teutronic-gmbh/corona-killer/Hardware/Zusatzplatine/ZusatzPlatine_Lochrasteraufbau.jpg

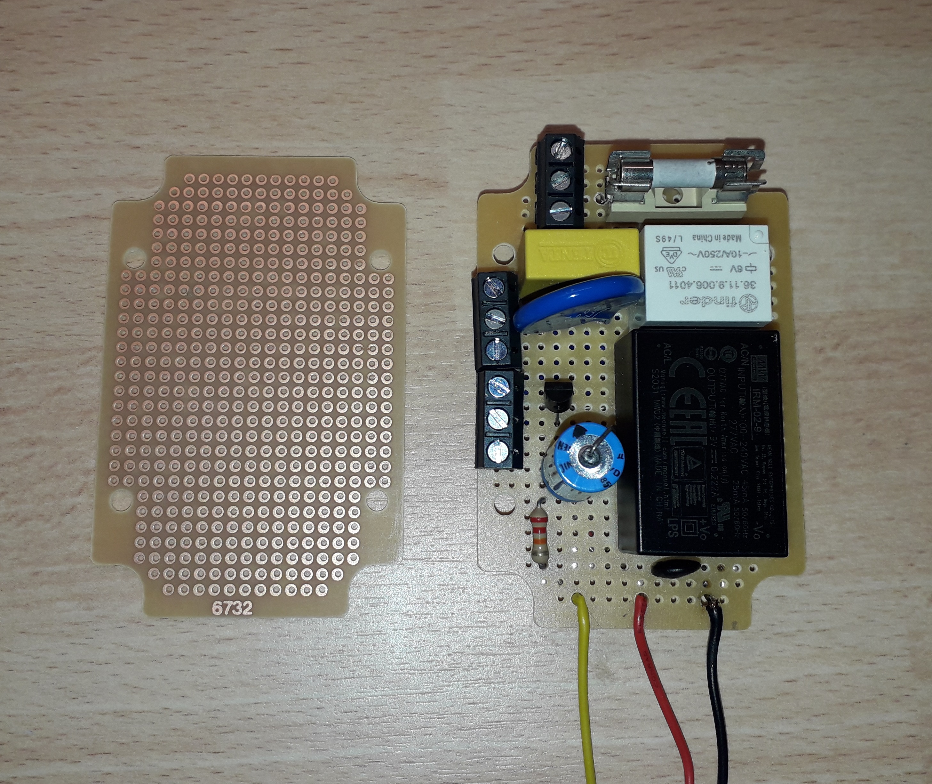
Hardware/Zusatzplatine/ZusatzPlatine_Lochrasteraufbau.jpg
