teutronic-gmbh/corona-killer/Hardware/Verdrahtung2.jpg

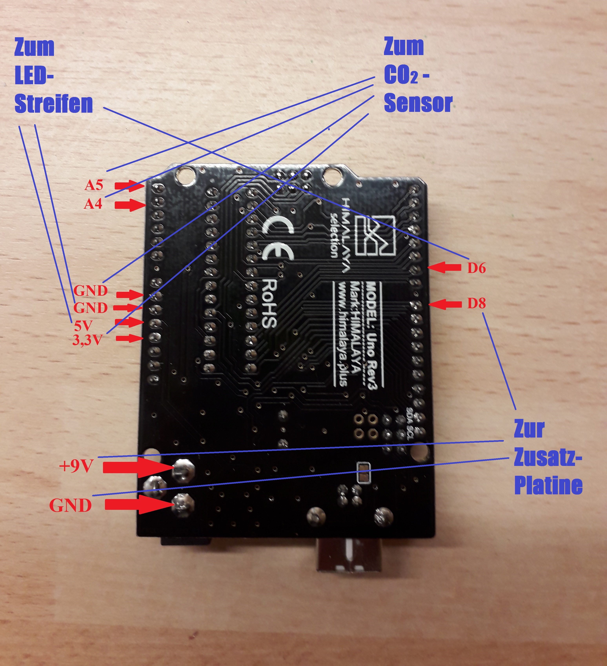
Hardware/Verdrahtung2.jpg
