teutronic-gmbh/corona-killer/README.md

# Corona-Killer

Luftsterilisation mittels UV-Licht

entworfen für den Einsatz in Klassenräumen im Winterhalbjahr 2020/2021

die eingebaute CO2-Messung erkennt die Anwesenheit von Schülern und schaltet die Luftsterilisation ein
