teutronic-gmbh/corona-killer/Hardware/Zusatzplatine/EAGLE/Luftsterilisator_1.3/Gerber/info.txt

Gerberfiles für Projekt "Coronakiller Zusatzplatine" Version 1.3 vom 26.11.2020

bei Problemen bitte hier nachfragen:

andreas.hertel@teutronic.de
Tel: 04137 810197
Mobil: 0170 3464377
