teutronic-gmbh/corona-killer/Hardware/Verdrahtung.png

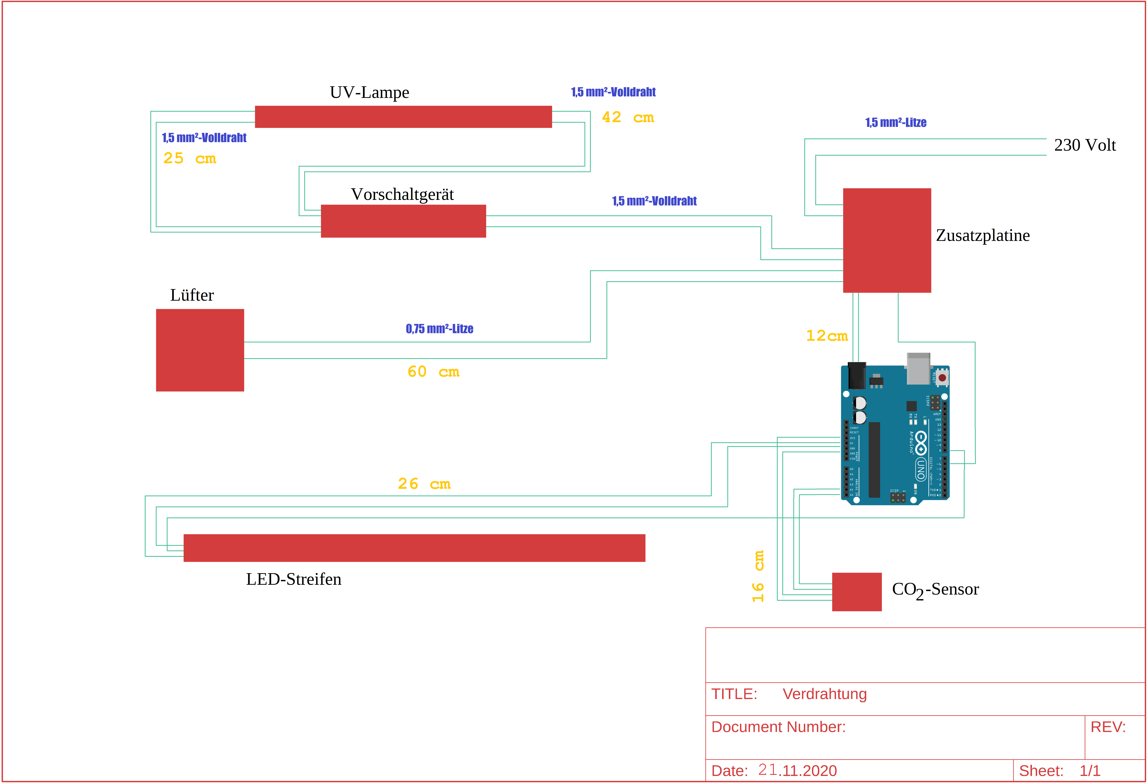
Hardware/Verdrahtung.png
