teutronic-gmbh/corona-killer/Materialliste.ods

Materialliste Coronakiller
Summe der Einzelpreise (inkl.MWSt): | 119,44 € | Anmerkung: hier nach dem 1.1.21 den Faktor 1,19 eintragen
 | Einzelpreis (netto) | Gebindepreis | Anzahl | Quelle | Bestellnummer | EAN
Osram Entkeimungslampe HNS 16W G5 25X1 | 5,18 € | 51,80 € | 10 | conrad.de | 756912 - 62 | 4008321620774
Lampenfassung G5 2er Set | 3,35 € | 33,50 € | 10 | conrad.de | 574874 – 62 | 4040267029334
LED Streifen 10er | 1,96 € | 5,87 € | 3 | conrad.de | 2161033 – 62 | 8717371232894
UNO R3 ATmega328P Board | 6,75 € |  |  | conrad.de | 802287391 – 62 | 4060137001697
SGP30 CO2 Sensor | 16,72 € |  |  | digikey.de | 1528-2531-ND
Vorschaltgerät 18W | 5,79 € |  |  | amazon.de | B00AGHVMQI
230V-Anschlußschnur | 1,74 € |  |  | voelkner.de | S382581 | 4016032311829
Rohreinschublüfter 180m³/h 125 | 27,88 € |  |  | abluft24.de | K011004s | 4251724209552
Gitter 125 2x | 5,07 € |  |  | abluft24.de | K111004 | 4251724204908 | (preiswerter Ersatz für AirCircleN33225)
Gitter 100 AirCircleN33212 2x | 6,47 € |  |  | Bauhaus.info | 13506934
PVC Rohr 125; 50 cm AirCircleN26202 | 6,68 € |  |  | Bauhaus.info | 13507452
Lüftungsschellen m.Einlage 2x | 4,36 € |  |  | abluft24.de | K101404 | 4251724204045
 |  |  |  |  |  |  | Nur für gedruckte Schaltung
Lochraster-Platine | 0,73 € |  |  | voelkner.de | S490641 | 2050004889628 | voelkner.de | S490641
3er Block Schraubklemme 3x | 0,45 € | 3,75 € | 25 | voelkner.de | D29609 | 2050000682551 | voelkner.de | D29609
Sicherung 1,6A träge | 0,17 € | 4,25 € | 25 | voelkner.de | S483451 | 2050004896558 | voelkner.de | S483451
Sicherungshalter | 0,13 € | 1,30 € | 10 | voelkner.de | S22688 | 2050000172588 | voelkner.de | S22688
MW IRM 02-9 | 4,61 € |  |  | voelkner.de | D920041 | 4021087034647 | voelkner.de | D920041
Relais | 1,16 € | 5,80 € | 5 | voelkner.de | S72788 | 2050000149450 | voelkner.de | S72788
NPN-Transistor | 0,16 € |  |  | conrad.de | 155012 – 62 | 2050000029431 | voelkner.de | Q35055
10kOhm-Widerstand | 0,06 € |  |  | conrad.de | 1417697 – 62 | 2050003798495 | voelkner.de | W78205
Kondensator 330nF / 400 Volt | 0,58 € |  |  | conrad.de | 808761445 – 62 |  | voelkner.de | W30668
Varistor S14K275 | 0,47 € |  |  | conrad.de | 500675 - 62 | 2050000141591 | voelkner.de | S29134
Kondensator 10µF | 0,42 € |  |  | conrad.de | 445591 – 62 | 2050000119705 | voelkner.de | W426471
Kondensator 100nF | 0,08 € |  |  | conrad.de | 1589524 – 6 | 2050004969900 | voelkner.de | W572401
Drähte (geschätzt) | 1,00 €
Schrauben/Muttern (geschätzt) | 1,00 €
UV-C Schutzbrille |  |  |  | conrad.de | 836647 – 62 | 4046719298037
