teutronic-gmbh/corona-killer/(threads)

Thread 2 (2020-11-06):

Refelktion der UV-Strahlung im Rohr

stockh0lm, 2020-11-06:
Wenn ich den Aufbau richtig verstehe ist das Rohr ein normales KG-Rohr, gell? In der Rechnung wird davon ausgegangen, dass das UV-Licht an der Oberfläche des Rohres (verlustfrei) gespiegelt wird.

- ist das KG-Rohr UV-stabil? KG-Rohre die ich an der Sonne sehe verfärben sich.
- für die Luftsterilisation ist es wichtig, dass möglichst viel der UV-Strahlung von der Wand zurückreflektiert wird. Ist das der Fall? kann man das Innere der Röhre sonst vielleicht mit Alufolie auskleiden oder ein Metallrohr nehmen?

teutronic-gmbh, 2020-11-06:
Ich hab da tatsächlich Alufolie verklebt wie sie zum Tapezieren verwendet wird. Die hat eine Rückseite mit Papier. Beim ersten Mal habe ich das ganz zum Schluss gemacht und überall mit dem Kleber rumgesaut. Das muss zu einem früheren Zeitpunkt des Zusammenbaus passieren. Daran feile ich noch  :-)

stockh0lm, 2020-11-14:
I read the mirror sheeting i am going to put in (or even the aluminium of a pipe reflects around 90% of the UV radiation back. That value is important to know for further simulation or calculation of the effective radiation intensity in the pipe.

Closed 2020-11-14.

Thread 3 (2020-11-06):

Fertigplatinen statt Lochrasterplatinen?

stockh0lm, 2020-11-06:
Es wäre möglich, Fehler bei der Verdrahtung zu vermeiden, indem man die Lochrasterplatine durch eine geätzte Platine ersetzt. Jemand (nicht notwendigerweise @teutronic-gmbh ) könnte ein solches Layout erstellen und beitragen, und Interessierte Schulen könnten die Platine in Kleinserie herstellen.

teutronic-gmbh, 2020-11-06:
Unter https://github.com/teutronic-gmbh/corona-killer/tree/main/Hardware/Zusatzplatine/EAGLE/Luftsterilisator
hab ich bereits eine solche Platine abgelegt, das mit dem Tool Eagle erstellt wurde.
Bisher wurde das aber noch nicht geätzt, ist also noch mit Vorsicht zu genießen. Ich will aber davon Platinen anfertigen lassen

Thread 4 (2020-11-06):

Sprache des Projekts

stockh0lm, 2020-11-06:
Es wäre möglich, das Projekt mehrsprachig aufzuziehen und Interessierten Übersetzern die Möglichkeit zu bieten, Landesspezifische Schoppinglisten und Anleitungen beizutragen. Wenn die englische Sprache als Standard hier auf Github keine Hürde für @teutronic-gmbh darstellt, würde das die Reichweite des Projekts vergrößern.

stockh0lm, 2020-11-14:
So i spoke with Andreas on the phone and she said that English would be fine for the primary language of this project. That means I will continue in english.

Closed 2020-11-14.

Thread 5 (2020-11-14):

perhaps one should add "sunglasses" to the shopping list?

stockh0lm, 2020-11-14:
After reading the product data sheet
https://dammedia.osram.info/media/resource/hires/osram-dam-4121389/PURITEC%20HNS%20Brochure%20(EN).pdf
I realize that protectie clothing might be advisable for construction and testing, as long as the caps are not installed on the tube.

The UV light can swiftly lead to sunburn and cause strong irritation to the eyes. sunglasses would prevent that.

Thread 6 (2020-11-14):

the UV light (the 185nm spectral line) of the lamp will generate ozon

stockh0lm, 2020-11-14:
While the product data sheet of the lamp says the lamp is ozon free, it also states that the wavelengths below 250nm will generate ozon, and the 185nm spectral line will likely do so.

Can we find out how much ozon is generated (gram/hour), and what results that has for humans in school classes? what are the permissive limits?

stockh0lm, 2020-11-14:
ok, this was not entirely correct. The specs say that the second spectral line at 185nm is filtered out by the special glass of the lamps, and the only UVC light coming out has 254nm - so no ozon after all.

Closed 2020-11-14.

Thread 7 (2020-11-14):

Noise level of the fan

stockh0lm, 2020-11-14:
I bought a medium range fan for 35€ which was marketed to be rather silent. Now that I hooked it up I dont find it so silent. It says 38dBA on the label. So in the future I would go for more expensive, more silent versions.

Thread 9 (2020-11-14):

Tool "ray optic simulation" to model the radiation density with different placements of the source

stockh0lm, 2020-11-14:
https://chrome.google.com/webstore/detail/ray-optics-simulation/egamlemiidmmmcccadndbjjihkcfiobh

this is a chrome extension that allows to model our setup and lets you play around with the source placement in the pipe.

stockh0lm, 2020-11-15:
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

this is the configuration as suggested in the schematics, modeled with this json file:

{"version":2,"objs":
[
  {"type":"arcmirror",
  "p1":{"type":1,"x":0,"y":725,"exist":true},
  "p2":{"type":1,"x":0,"y":726,"exist":true},
  "p3":{"type":1,"x":1250,"y":725,"exist":true}
},
  {"type":"radiant","x":150,"y":725,"p":0.001}],"mode":"light","rayDensity_light":0.05,"rayDensity_images":1,"observer":null,"origin":{"x":0,"y":0}
}

stockh0lm, 2020-11-15:
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

This is the configuration with the light source in the middle:

{"version":2,"objs":
[
  {"type":"arcmirror",
  "p1":{"type":1,"x":0,"y":725,"exist":true},
  "p2":{"type":1,"x":0,"y":726,"exist":true},
  "p3":{"type":1,"x":1250,"y":725,"exist":true}
},
  {"type":"radiant","x":625,"y":725,"p":0.001}],"mode":"light","rayDensity_light":0.05,"rayDensity_images":1,"observer":null,"origin":{"x":0,"y":0}
}

stockh0lm, 2020-11-15:
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

This is the configuration with the light source at half the pipe-radius (31.7mm), with this json file:

{"version":2,"objs":
[
  {"type":"arcmirror",
  "p1":{"type":1,"x":0,"y":725,"exist":true},
  "p2":{"type":1,"x":0,"y":726,"exist":true},
  "p3":{"type":1,"x":1250,"y":725,"exist":true}
},
  {"type":"radiant","x":317,"y":725,"p":0.001}],"mode":"light","rayDensity_light":0.05,"rayDensity_images":1,"observer":null,"origin":{"x":0,"y":0}
}

stockh0lm, 2020-11-15:
This shows that the placement of the light source would be best in the middle of the pipe. The rule of thumb would be: the more in the middle the better.

stockh0lm, 2020-11-15:
with raytracing software like Blender this can be modeled better.

Thread 11 (2020-11-25):

insufficient irradiation intensity?

stockh0lm, 2020-11-25:
Depending on the source of the irradiation dose for sars-cov-19, it is either 611uJ/cm^2 or 10,3mJ/cm^2. (The first one is from a marketing paper, so i would rather rely on the second, which is from a scientific paper.

In my current configuration (where i measured the air speed in the tube) and according to my calculation, we do not reach that dose reliably.

Here is my calculation:

measured air speed in the tube with vane annemometer: 3m/s
UVC irradiation power from lamp: 4W
(from https://www.osram.de/ecat/PURITEC%20HNS%20UV-C-UV-C%20lamps%20for%20purification-Ultraviolettstrahler-Industrie-Spezialbeleuchtung/de/de/GPS01_1028570/ZMP_1022255/ )
With the lamp in the center of the tube we have a radialsymmetrical irradiation distribution, weakest at the inner tube surface. This surface A is 12.5cm * 22.8cm * pi = 895cm^2
irradiation power / surface: 4W/895cm^2 = 0.004467W/cm^2
mean residence time of air/germ in irradiation: 0.228m / 3m/s = 0.076s

irradiation dose at inner tube surface: 0.076s* 0.004467W/cm^2 = 339uJ/cm^2

You could argue that due to the reflection on the inner mirror surface of the tube the irradiation is twice that value. I would not like to argue that way, because the 4W are not actually focused in the volume but spread out further. That increases the mean residence time, but decreases the irradiation power.  Even then we would just reach the lower, first marketing paper numer for the irradiation dose, but fall short of the second by a factor of 30.

Only the inner fifth of the tube would reach the precribed irradiation dose of 10.3mJ/cm^2. While the germicidal effect outside that volume is still there, it might not reach the desired 90%.

stockh0lm, 2020-11-25:
According to https://www.osram.de/appsj/pdc/pdf.do?cid=GPS01_1028570&vid=PP_EUROPE_DE_eCat&lid=DE&mpid=
which lists the other germicidal lamps by osram, even the high end bulb HNS L 95 W 2G11 with 27 W UVC output and a length of 533,0 mm would not reach the required radiation intensity. I do hope that I screwed up this calculation. Please check, someone.

stockh0lm, 2020-11-26:
it appears that the 10.3mJ/cm^2 is for 99% inactivation dose, not 90%. see other issue.

stockh0lm, 2020-12-01:
import numpy as np

step_num = 1e4

r_l = .016 / 2
r_c = .125 / 2
stepsize = (r_c - r_l) / step_num

l = .205
k = .41
v = 3.0
e = 4.0

t = l / v

volume_total = 2 * np.pi * l * (r_c ** 2 - r_l ** 2)

killrate = 0.0
for r_diff in np.arange(r_l, r_c, stepsize):
    i = e / (2 * np.pi * l * r_diff)
    d = i * t
    p = 1 - np.exp(-k * d)
    v_diff = np.pi * l * (r_diff * stepsize + stepsize ** 2)
    volume_partial = v_diff / volume_total
    killrate += p * volume_partial

print("killrate_total: ", killrate)

This will calculate the overall killrate of our device with the current configuration and the parameters i was able to collect and measure.

it calculates a overall killrate of 0.21685570284082964.
21% of covid-19 viruses that pass through the device are killed. That is not as impressive as i had hoped.

What can we do to make the device more potent?

stockh0lm, 2020-12-01:
Since the intensity and dose decrease quadratically with distance, it could help (a lot) to install several equidistant lamps into one pipe. I will try to compute what killrate is attainable that way.

stockh0lm, 2020-12-01:
after finding two bugs in my calculation and arriving at a killrate of 0.86, i am happy and close this issue

Closed 2020-12-01.
