teutronic-gmbh/corona-killer/Hardware/Zusatzplatine/coronakiller_Zusatzplatine.pdf

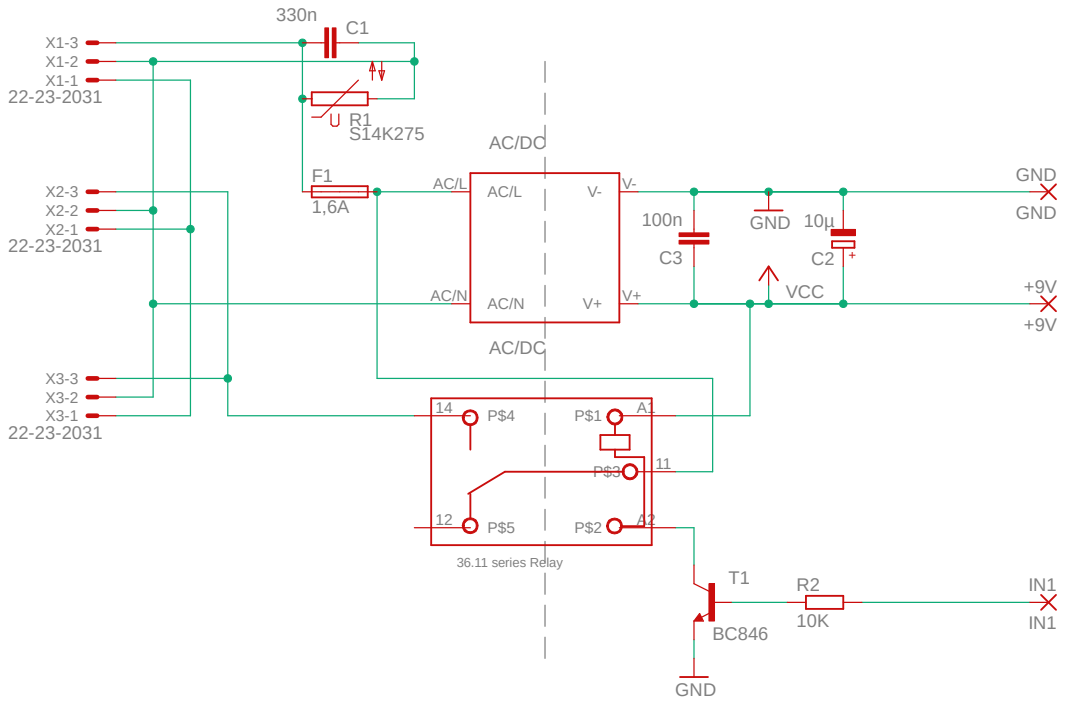
[picture p4: page 1]
GND; VCC; 36.11 series Relay; TITLE:; coronakiller_Zusatzplatine

Document Number: | REV: 1.1

Date: 06.11.2020 16:15 | Sheet: 1/1

06.11.2020 16:16 C:\Users\Andreas Hertel\Documents\EAGLE\projects\Luftsterilisator\coronakiller_Zusatzplatine.sch (Sheet: 1/1)
