teutronic-gmbh/corona-killer/Mechanik/Bohrschablone.pdf

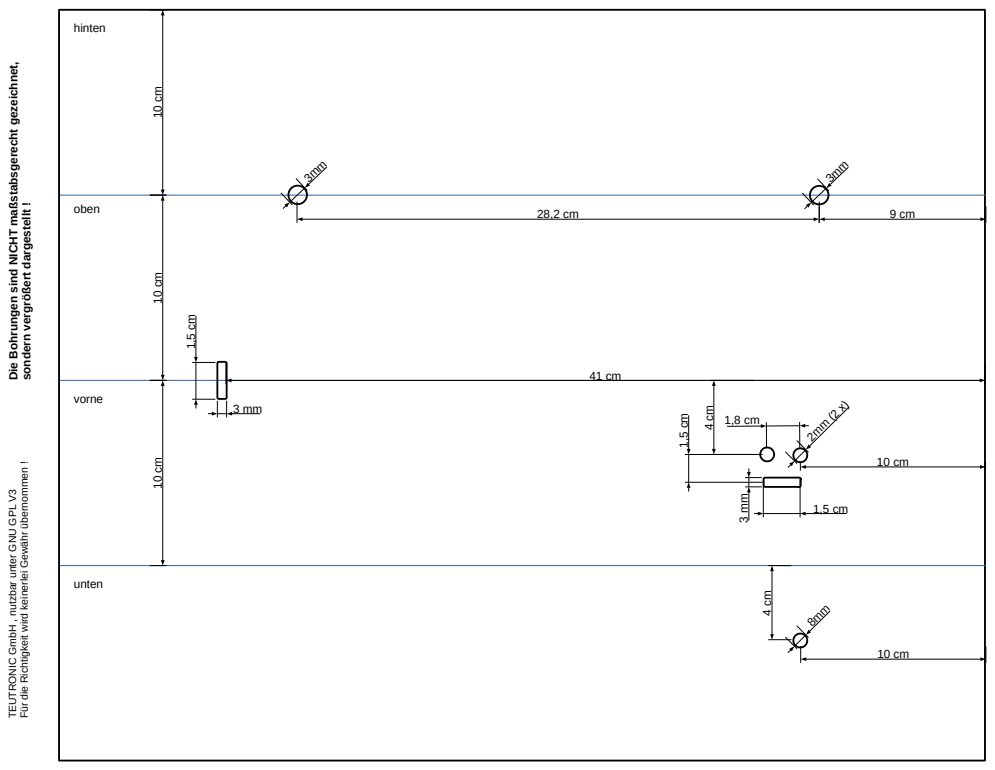
[picture p5: page 1]
hinten; oben; vorne; unten

Die Bohrungen sind NICHT maßstabsgerecht gezeichnet,

sondern vergrößert dargestellt !

Für die Richtigkeit wird keinerlei Gewähr übernommen !

TEUTRONIC GmbH , nutzbar unter GNU GPL V3
