teutronic-gmbh/corona-killer/Hardware/Zusatzplatine/EAGLE/Luftsterilisator_1.3/coronakiller_Zusatzplatine.brd

## EAGLE design Hardware/Zusatzplatine/EAGLE/Luftsterilisator_1.3/coronakiller_Zusatzplatine.brd (2020-11-26)

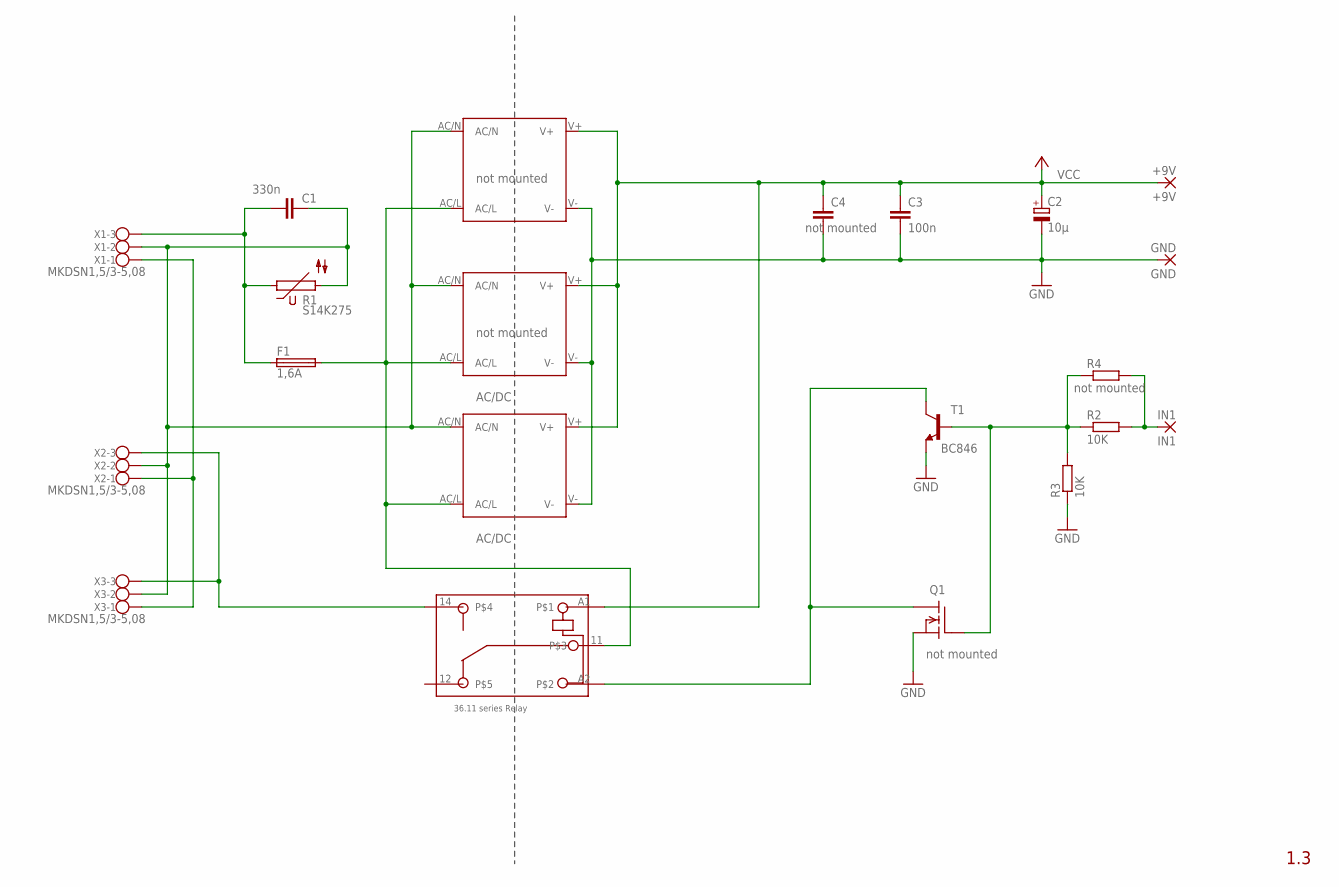
[picture p6: schematic coronakiller_Zusatzplatine.sch]

Parts:
+9V: +9V; 2,54/1,0
AC/DC: AC/DC; IRM_03
C1: 330n; C150-054X183
C2: 10µ; E2,5-6
C3: 100n; C0805
C4: not mounted; C025-040X050
F1: 1,6A; SH22,5
GND: GND; 2,54/1,0
IN1: IN1; 2,54/1,0
K1: 36.11
Q1: BSS101; TO92
R1: S14K275
R2, R3: 10K; R0805
R4: not mounted; V526-0
T1: BC846; SOT23
U$1: not mounted; IRM_01/02
U$2: not mounted; IRM_01/02_SMD
X1, X2, X3: MKDSN1,5/3-5,08

Connections:
GND: AC/DC.V-, C2.-, C3.2, C4.2, GND.1, Q1.1 (S), R3.1, T1.2 (E), U$1.V-, U$2.V-
unnamed: C1.2, F1.1, R1.1, X1.3
unnamed: AC/DC.AC/N, C1.1, R1.2, U$1.AC/N, U$2.AC/N, X1.2, X2.2, X3.2
unnamed: X1.1, X2.1, X3.1
unnamed: AC/DC.AC/L, F1.2, K1.11, U$1.AC/L, U$2.AC/L
unnamed: K1.A2, Q1.3 (D), T1.3 (C)
unnamed: Q1.2 (G), R2.1, R3.2, R4.1, T1.1 (B)
unnamed: IN1.1, R2.2, R4.2
unnamed: K1.14, X2.3, X3.3
VCC: +9V.1, AC/DC.V+, C2.+, C3.1, C4.1, K1.A1, U$1.V+, U$2.V+

Notes on the sheet:
1.3
not mounted

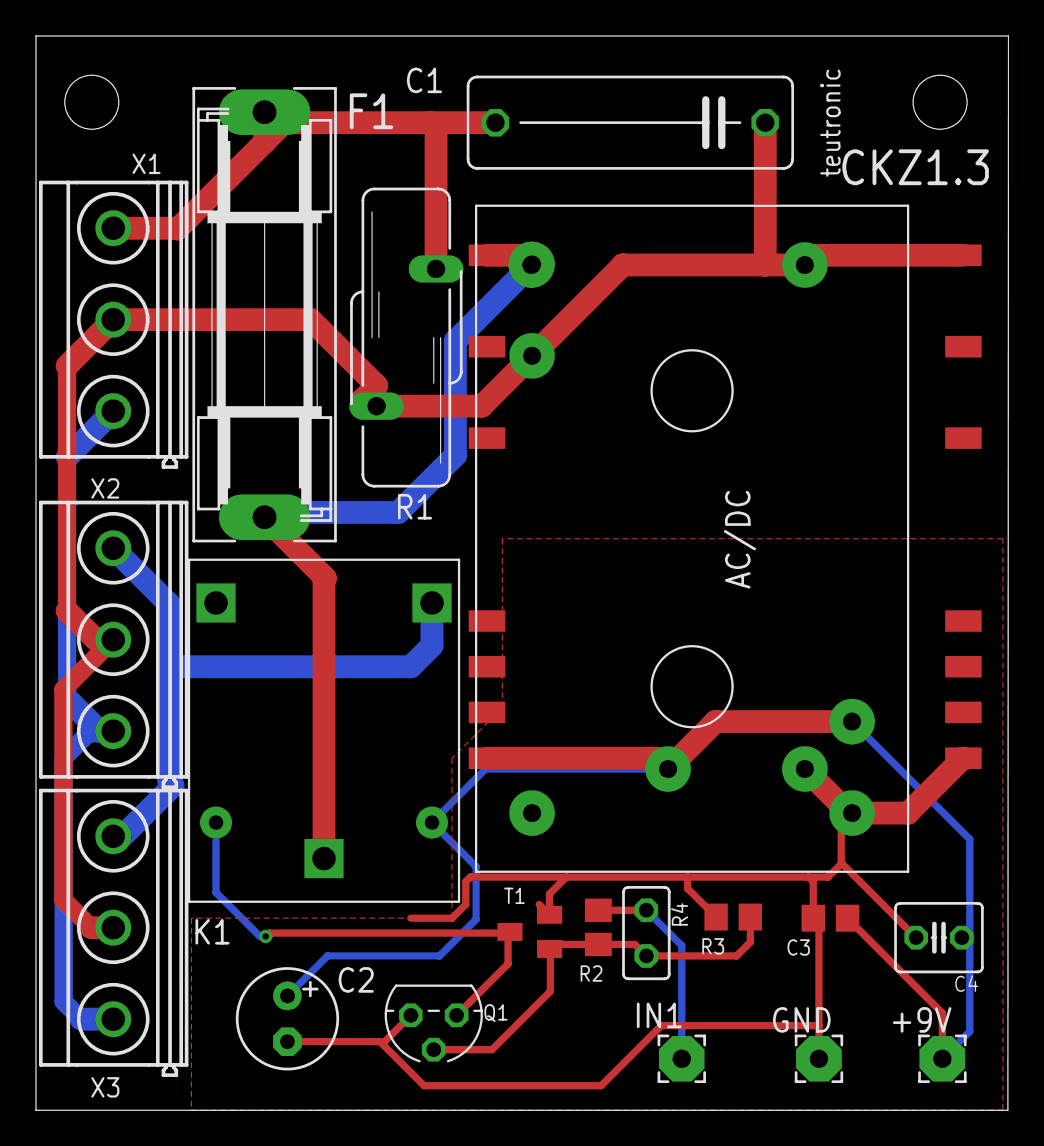
[picture p7: board coronakiller_Zusatzplatine.brd from above]

Board: 2 copper layers, 54.0 x 59.7 mm, 21 parts (0 on the bottom side), 10 nets.
