teutronic-gmbh/corona-killer/Hardware/Zusatzplatine/EAGLE/Luftsterilisator_1.2/coronakiller.brd

## EAGLE design Hardware/Zusatzplatine/EAGLE/Luftsterilisator_1.2/coronakiller.brd (2020-10-25)

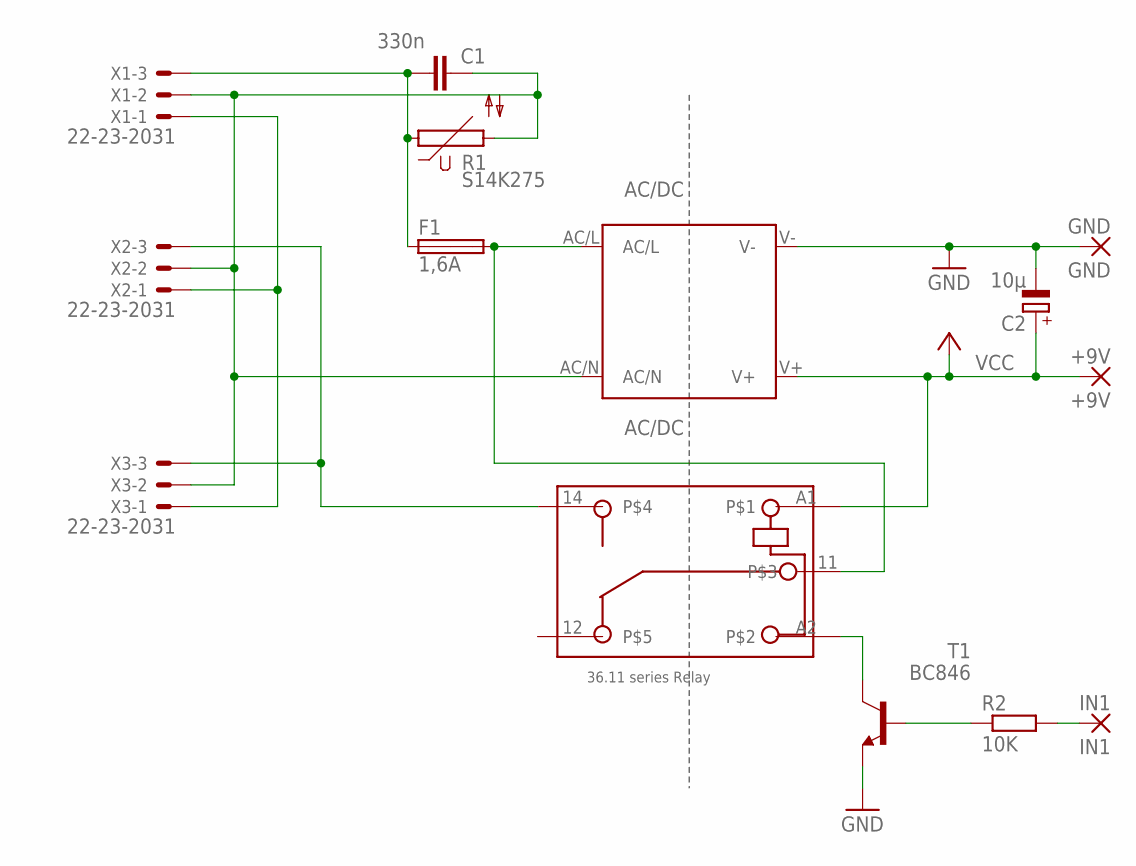
[picture p8: schematic coronakiller.sch]

Parts:
+9V: +9V; 2,54/1,0
AC/DC: AC/DC; IRM_03
C1: 330n; C150-054X183
C2: 10µ; E2,5-6
F1: 1,6A; SHK20Q
GND: GND; 2,54/1,0
IN1: IN1; 2,54/1,0
K1: 36.11
R1: S14K275
R2: 10K; R0805
T1: BC846; SOT23
X1, X2, X3: 22-23-2031

Connections:
GND: AC/DC.V-, C2.-, GND.1, T1.2 (E)
unnamed: AC/DC.AC/N, C1.1, R1.2, X1.2, X2.2, X3.2
unnamed: X1.1, X2.1, X3.1
unnamed: C1.2, F1.1A, R1.1, X1.3
unnamed: AC/DC.AC/L, F1.2A, K1.11
unnamed: K1.A2, T1.3 (C)
unnamed: R2.1, T1.1 (B)
unnamed: IN1.1, R2.2
unnamed: K1.14, X2.3, X3.3
VCC: +9V.1, AC/DC.V+, C2.+, K1.A1

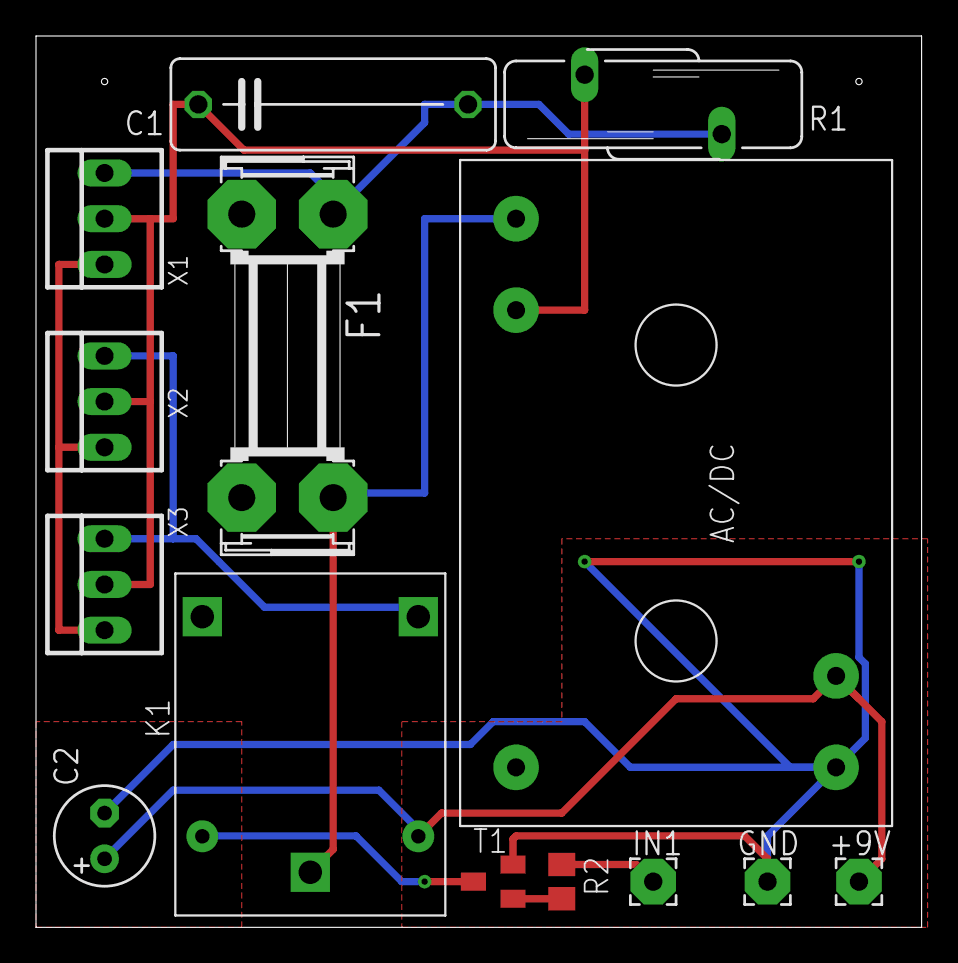
[picture p9: board coronakiller.brd from above]

Board: 2 copper layers, 49.2 x 49.5 mm, 14 parts (0 on the bottom side), 10 nets.
