teutronic-gmbh/corona-killer/(commit log)

2020-10-25 pretested arduino software
2020-10-25 Hardware files , first commit
    [coronakiller.brd, coronakiller.sch]
2020-11-03 Image of the additional board
2020-11-06 add material list
    [Materialliste.ods]
2020-11-06 material list corrected
    [Materialliste.ods]
2020-11-06 added wiring diagram
2020-11-07 more details in wiring diagram
2020-11-09 material list updated
    [Materialliste.ods]
2020-11-10 redesigned EAGLE layout , now version 1.2
    [coronakiller_Zusatzplatine.brd, coronakiller_Zusatzplatine.sch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]
2020-11-20 update material list
    [Materialliste.ods]
2020-11-26 new hardware version 1.3
    [coronakiller.brd, coronakiller.sch, coronakiller_Zusatzplatine.brd, coronakiller_Zusatzplatine.sch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]
